stubbsd/Carvera-Spindle-Controller/docs/escon/01_motor.png

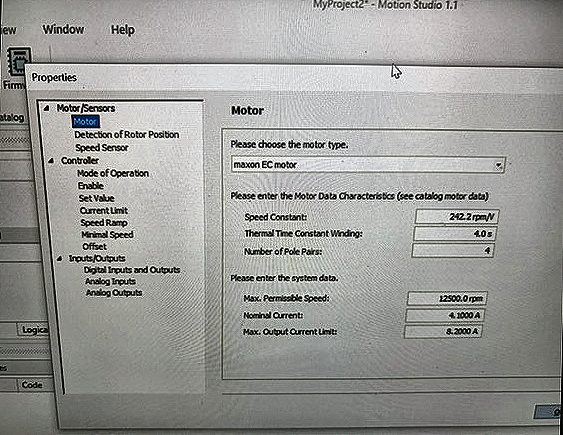
docs/escon/01_motor.png
