stubbsd/Carvera-Spindle-Controller/docs/escon/02_rotor_position.png

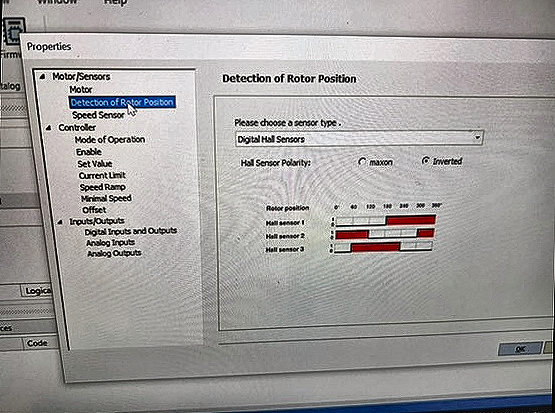
docs/escon/02_rotor_position.png
