stubbsd/Carvera-Spindle-Controller/docs/escon/03_speed_sensor.png

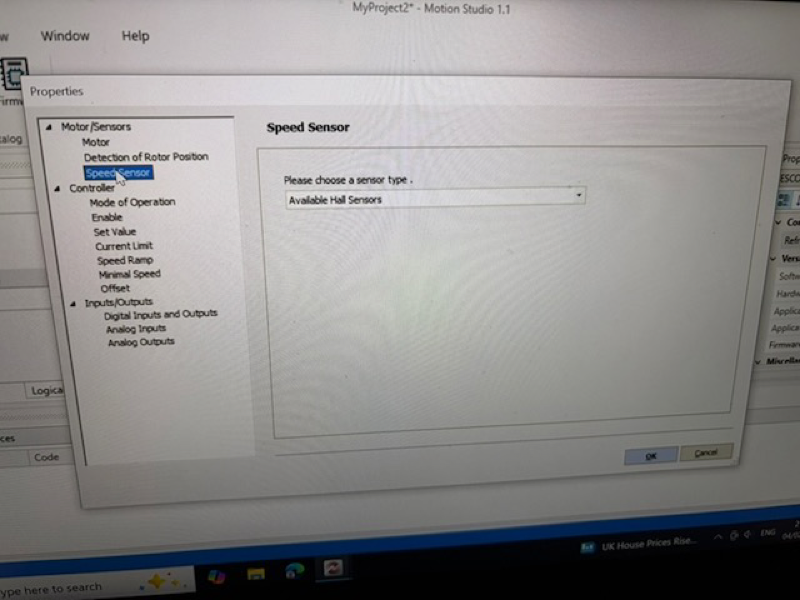
docs/escon/03_speed_sensor.png
