stubbsd/Carvera-Spindle-Controller/docs/escon/05_enable.png

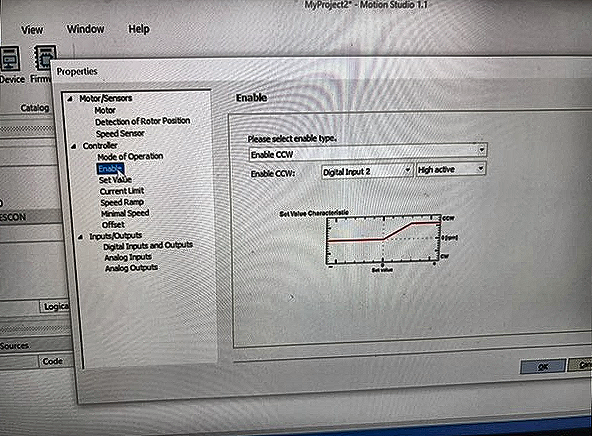
docs/escon/05_enable.png
