stubbsd/Carvera-Spindle-Controller/docs/escon/06_set_value.png

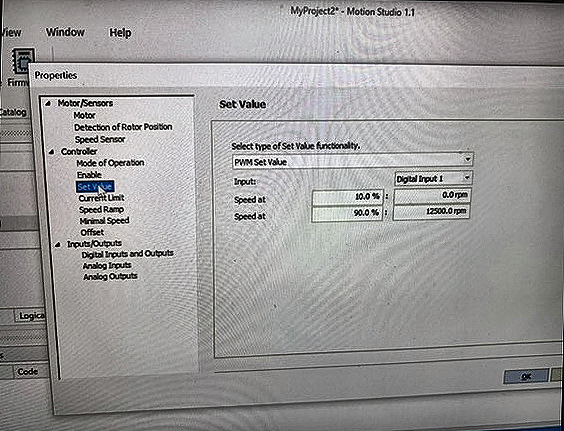
docs/escon/06_set_value.png
