stubbsd/Carvera-Spindle-Controller/docs/escon/07_current_limit.png

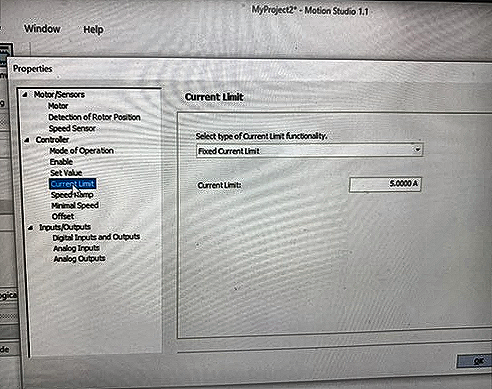
docs/escon/07_current_limit.png
