stubbsd/Carvera-Spindle-Controller/docs/escon/08_speed_ramp.png

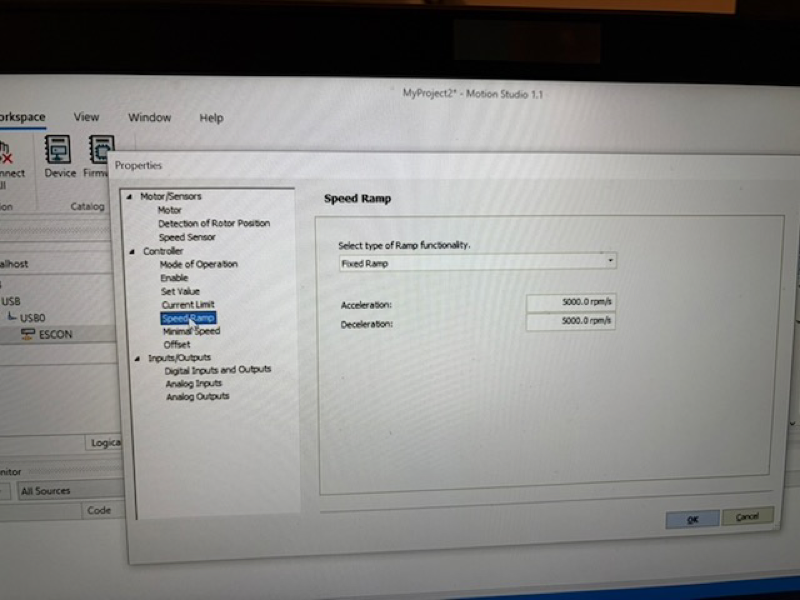
docs/escon/08_speed_ramp.png
