stubbsd/Carvera-Spindle-Controller/docs/escon/09_minimal_speed.png

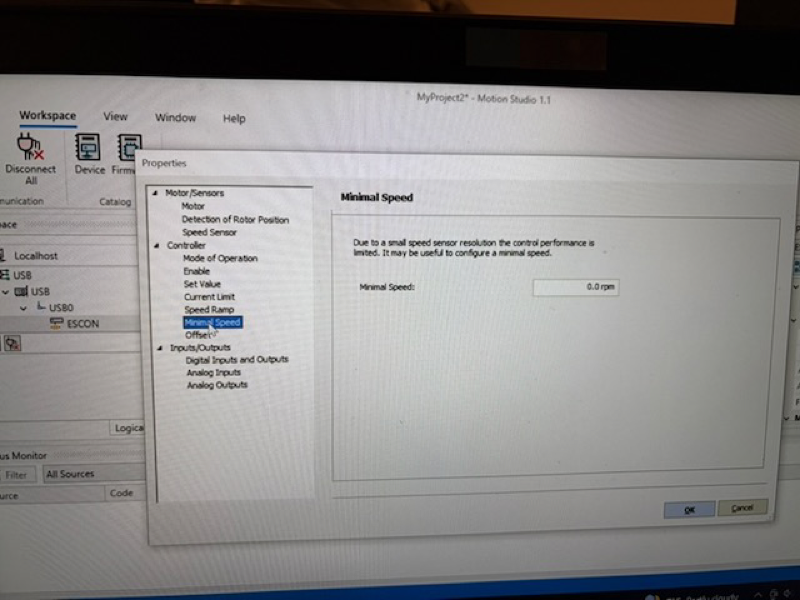
docs/escon/09_minimal_speed.png
