stubbsd/Carvera-Spindle-Controller/docs/escon/11_digital_io_overview.png

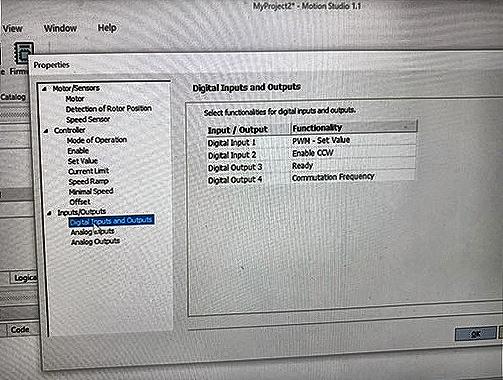
docs/escon/11_digital_io_overview.png
