stubbsd/Carvera-Spindle-Controller/docs/escon/12_digital_output3_ready.png

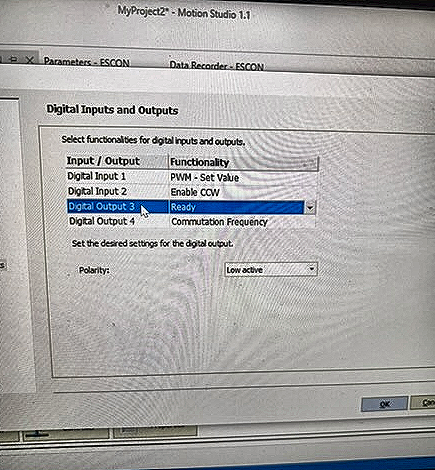
docs/escon/12_digital_output3_ready.png
