stubbsd/Carvera-Spindle-Controller/docs/escon/13_digital_output4_commutation.png

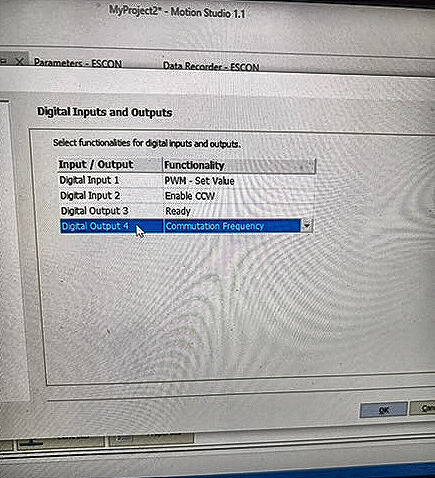
docs/escon/13_digital_output4_commutation.png
