stubbsd/Carvera-Spindle-Controller/docs/escon/14_analog_inputs.png

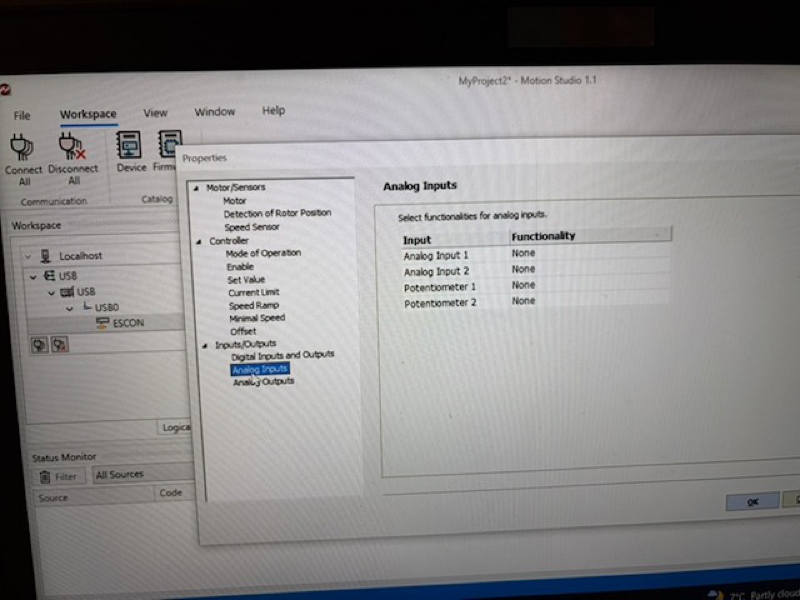
docs/escon/14_analog_inputs.png
