stubbsd/Carvera-Spindle-Controller/docs/escon/15_analog_output_current.png

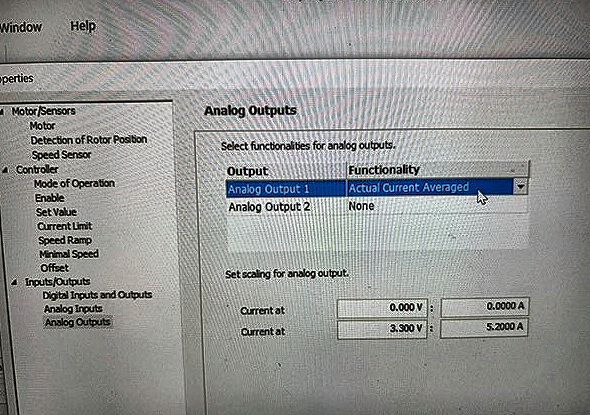
docs/escon/15_analog_output_current.png
