stubbsd/Carvera-Spindle-Controller/docs/escon/04_mode_of_operation.png

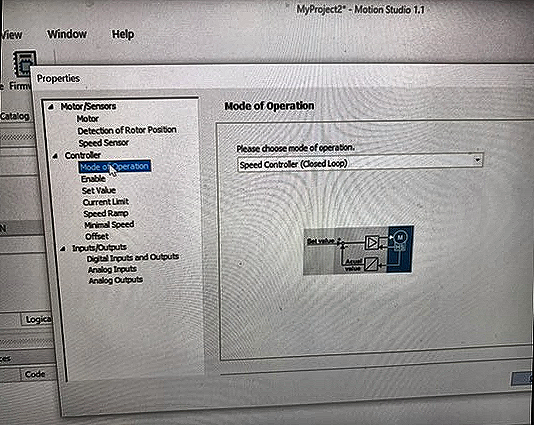
docs/escon/04_mode_of_operation.png
