stubbsd/Carvera-Spindle-Controller/(commit log)

2026-02-27 deps: bump panic-probe from 0.3.2 to 1.0.0
    Bumps [panic-probe](https://github.com/knurling-rs/defmt) from 0.3.2 to 1.0.0.
    - [Release notes](https://github.com/knurling-rs/defmt/releases)
    - [Changelog](https://github.com/knurling-rs/defmt/blob/main/CHANGELOG.md)
    - [Commits](https://github.com/knurling-rs/defmt/compare/panic-probe-v0.3.2...defmt-v1.0.0)
    ---
    updated-dependencies:
    - dependency-name: panic-probe
    dependency-version: 1.0.0
    dependency-type: direct:production
    update-type: version-update:semver-major
    ...
2026-02-27 Fix flaky calibration tests with serial_test
    Tests sharing static calibration state (CAL_POINTS, CAL_COUNT) and error
    state atomics were intermittently failing due to parallel execution.
    Add serial_test crate and #[serial] attribute to all tests that modify
    shared static state: 23 calibration table tests, 2 integration tests,
    and 14 error state tests.
    [lib.rs, state.rs, table.rs]
2026-02-27 Reference open-loop firmware PR in README
    Note that open-loop spindle mode is pending in Carvera Community
    Firmware PR #265 and users can build from the PR branch until it
    is merged.
2026-02-27 docs: Add detailed ESCON Studio configuration with screenshots
    Replace the sparse 5-step ESCON configuration with comprehensive
    14-step guide covering all ESCON Studio panels: motor, rotor position,
    speed sensor, mode of operation, enable, set value, current limit,
    speed ramp, minimal speed, offset, digital I/O, analog I/O, and
    save. Add 10 annotated screenshots in docs/escon/. Add Act V
    (micro USB warning) to cautionary tales.
2026-02-28 Added image of the pico in place and routing the display wire.
2026-03-01 Add calibration demo GIF, firmware build guide, and expanded README
